agar-ayamsegar/agar-data-collection/hardware/box_v2/airflow-sim.html

Agar · sensor box v2 · airflow study

# Where the fan and sensors should go

Seven ways to build the test box, from the box you have now to a box that holds the smell, mixes it, reads it and flushes itself. Pick a design, switch phases, and watch what the sensor sees. Blue dots are ammonia (lighter than air), orange dots are the heavier spoilage gases.

ammonia, rises amines, H₂S, acids, sink air movement sensor

Drag to rotate · scroll or pinch to zoom

Design

### —

At sensor

0

In box

0

Trapped

0

What the sensor sees, last 40 s of simulated time

Pause Restart this design Labels Air

Simulated time runs about 20× faster than real minutes. Dot counts are relative: compare designs by shape, not by the number.

Before placing the fan

## Ammonia rises. The smell that stays low is the gas under the chicken.

Ammonia weighs 17 g/mol against 29 for air, so in still air it drifts up. Most of the other spoilage gases (amines, hydrogen sulfide, the acids behind “asem”) are heavier and settle slowly. At the tiny amounts a chicken gives off, warm air and the MQ heaters mix things more than weight does, but in a still box it takes minutes.

What really stays at the bottom is the part of the chicken that touches the floor. No air reaches that skin, and the drip that pools there holds a lot of ammonia, because ammonia dissolves easily in water. That gas leaks out slowly and unevenly, so two runs of the same chicken can read differently depending on how it was lying.

The fix is a rack before any fan: a stainless grid 2–3 cm above the floor, with a washable drip tray under it. Then air reaches the underside, and a gentle fan can carry that gas to the sensor.

Gas | g/mol | In still air | Seen by
Air (reference) | 29 | — | —
Ammonia NH₃ · “pesing” | 17 | rises | MQ-137, MQ-135
Hydrogen sulfide H₂S · rotten egg | 34 | sinks a little | MQ-135
CO₂ (bacteria breathing) | 44 | sinks | MQ-135
Ethanol · “glue/solvent” | 46 | sinks | MQ-135
Trimethylamine · fishy, amis | 59 | sinks | MQ-137, MQ-135
Acetic acid · “asem” | 60 | sinks | MQ-135

The seven designs

## Fan, sensor and box, side by side

Whatever you build

## Rules that keep the ratio honest

Same fan state in baseline and sampleMoving air cools the MQ heater and changes the reading by itself. If the fan runs during the sample, it runs the same way, at the same speed, during the baseline.

Never blow straight at the sensorsPut them in the return path of the loop, where mixed air passes at a gentle, steady speed.

In a tube, the fan goes after the sensorsThe air reaches the sensors before it touches the motor, which is warm and can carry its own smell.

Purge through a carbon filterThen every baseline starts from the same clean air, whatever the room smells like. Carbon doesn't remove humidity, so keep logging the DHT11.

New box = new dataset versionTag the JSON with "method": "box_v2_D" (or similar) and run the first few chickens in both boxes, so old and new ratios can be compared.

Chicken in the same spot, every timeCentre of the rack, same side up. Mark the spot on the grid.

Recommended for data collection now

## Design D: hold, mix, flush

It keeps the strong signal of your current closed-box method (the 5-minute hold), adds a short mix so the sensor reads the average air instead of whatever drifted past, and flushes itself with filtered air so you never have to open the lid to purge. Later, the through-flow design (C) is the one that matches the handheld sniffer; run a few chickens in both to learn how the two relate.

Step | Fans | Time
Flush (empty box) | exhaust on, filter inlet open | 2 min
Baseline (empty, closed) | off, then stir 20 s | 5 min
Chicken in on the rack, hold | all off | 5 min
Mix, then read | stir fan on, low speed | 20–30 s
Chicken out, flush | exhaust on | 2 min

Part | Note
Stainless rack + drip tray | 2–3 cm high, washable
Stir fan, 40 mm 5 V | inside, top corner, low speed
Exhaust fan, 40 mm 5 V | on the outlet, top right, outside the box
Inlet with carbon filter | bottom left, opposite the outlet; cap it during the hold
2 × logic MOSFET + diode | so the Arduino switches each fan (IRLZ44N or similar)

This is a qualitative particle simulation to compare layouts: gas dots drift, rise or sink and follow a simple air pattern for each fan setup. It shows where air goes and roughly how fast, not exact concentrations. Check a real build with the breath test and an empty-box flush before collecting data.
