agar-ayamsegar/agar-data-collection/hardware/box_v2/render/part_filter_port.png

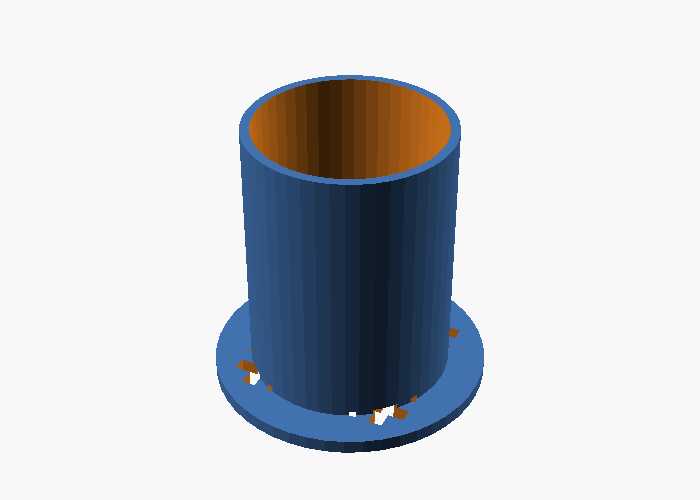
hardware/box_v2/render/part_filter_port.png
