agar-ayamsegar/agar-data-collection/hardware/box_v2/render/part_sensor_wall_mount.png

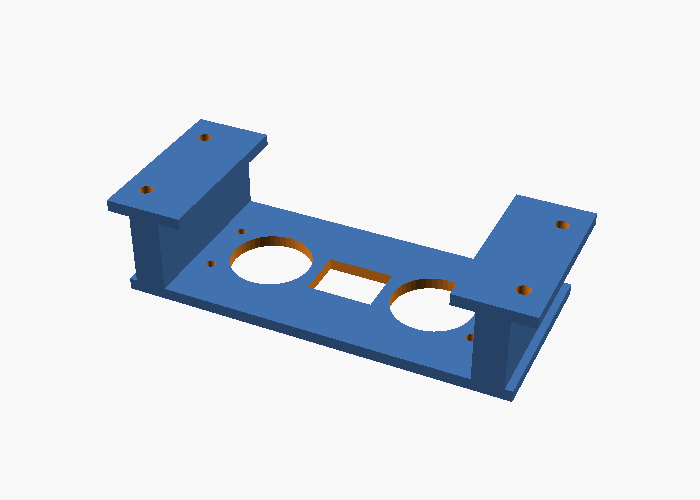
hardware/box_v2/render/part_sensor_wall_mount.png
