agar-ayamsegar/agar-data-collection/hardware/box_v2/render/part_throat_collar.png

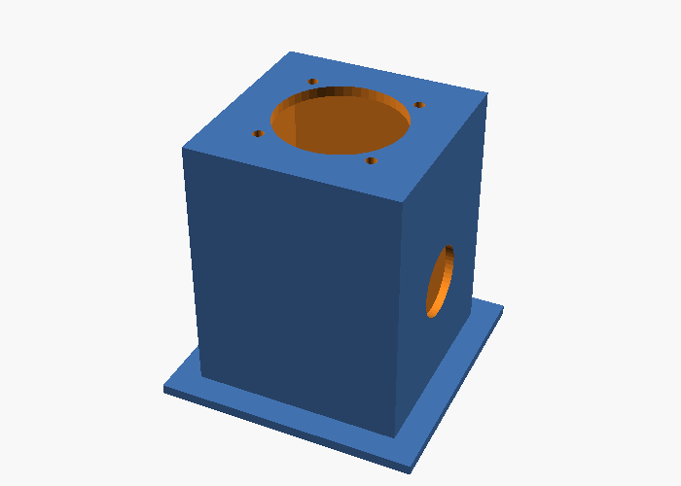
hardware/box_v2/render/part_throat_collar.png
