agar-ayamsegar/agar-data-collection/hardware/box_v2/stl/throat_collar.stl

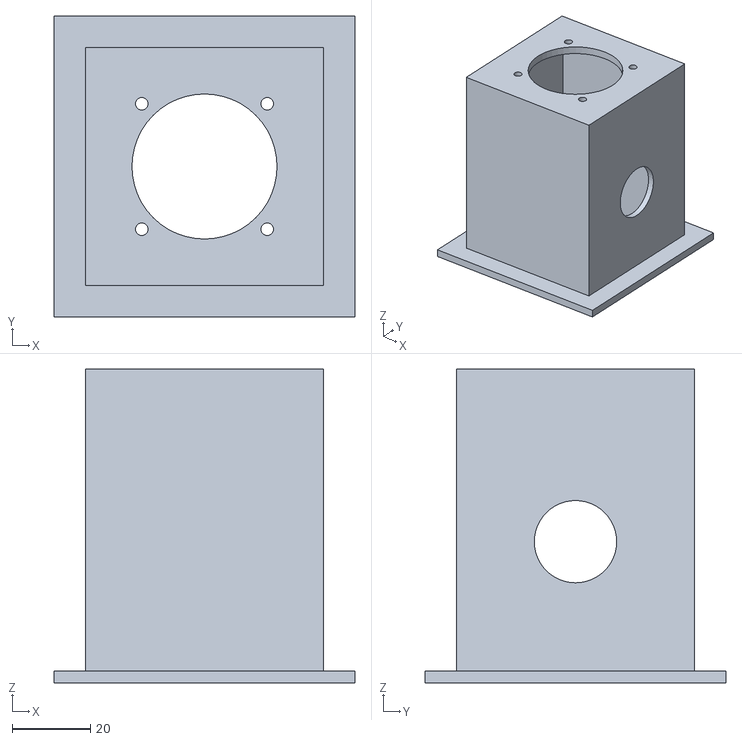
[picture p11: CAD file, 2026-10-28]
hardware/box_v2/stl/throat_collar.stl
76.8 x 76.8 x 80.0
