agar-ayamsegar/agar-data-collection/hardware/box_v2/stl/rack_foot.stl

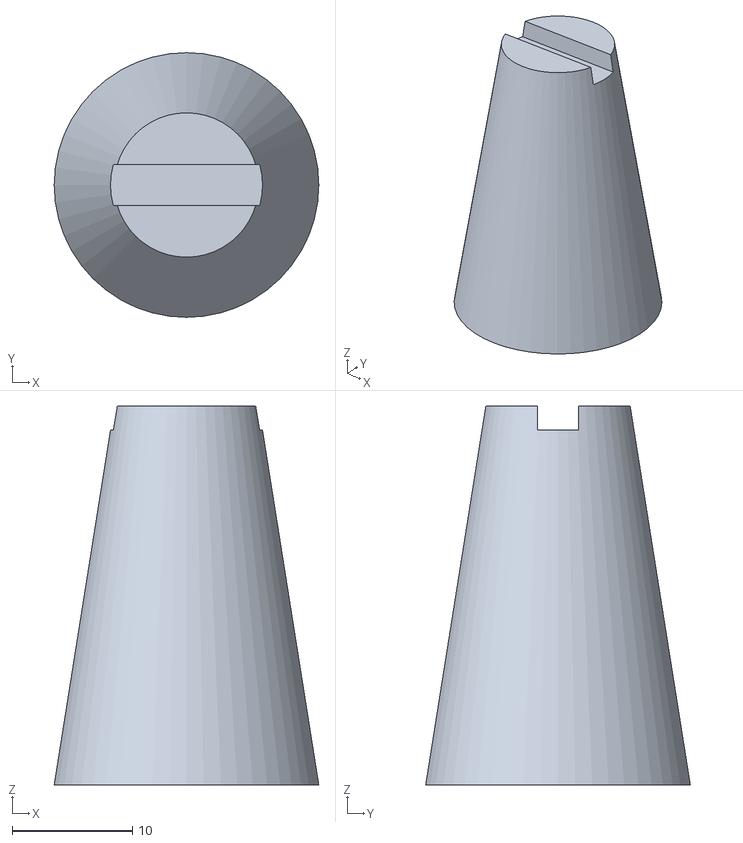
[picture p12: CAD file, 2026-10-28]
hardware/box_v2/stl/rack_foot.stl
22.0 x 22.0 x 31.5
