agar-ayamsegar/agar-data-collection/hardware/box_v2/stl/filter_port.stl

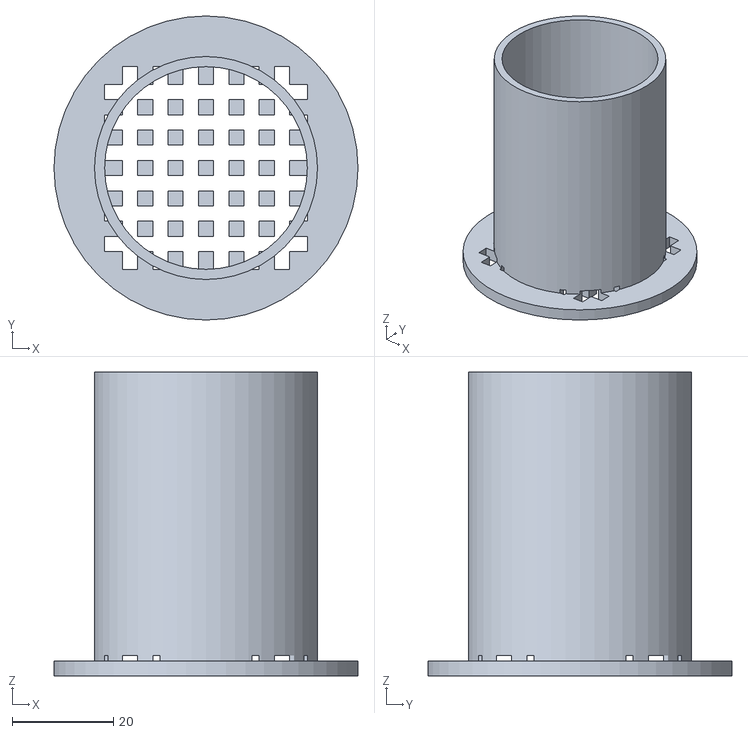
[picture p13: CAD file, 2026-10-28]
hardware/box_v2/stl/filter_port.stl
60.0 x 60.0 x 60.0
