agar-ayamsegar/agar-data-collection/hardware/box_v2/stl/tube_port.stl

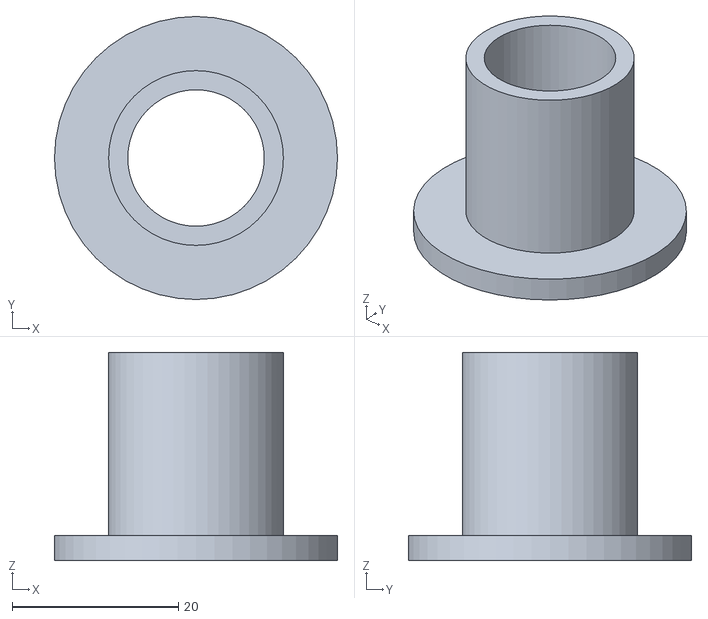
[picture p14: CAD file, 2026-10-28]
hardware/box_v2/stl/tube_port.stl
34.0 x 34.0 x 25.0
