agar-ayamsegar/agar-data-collection/hardware/box_v2/stl/throat_collar_E.stl

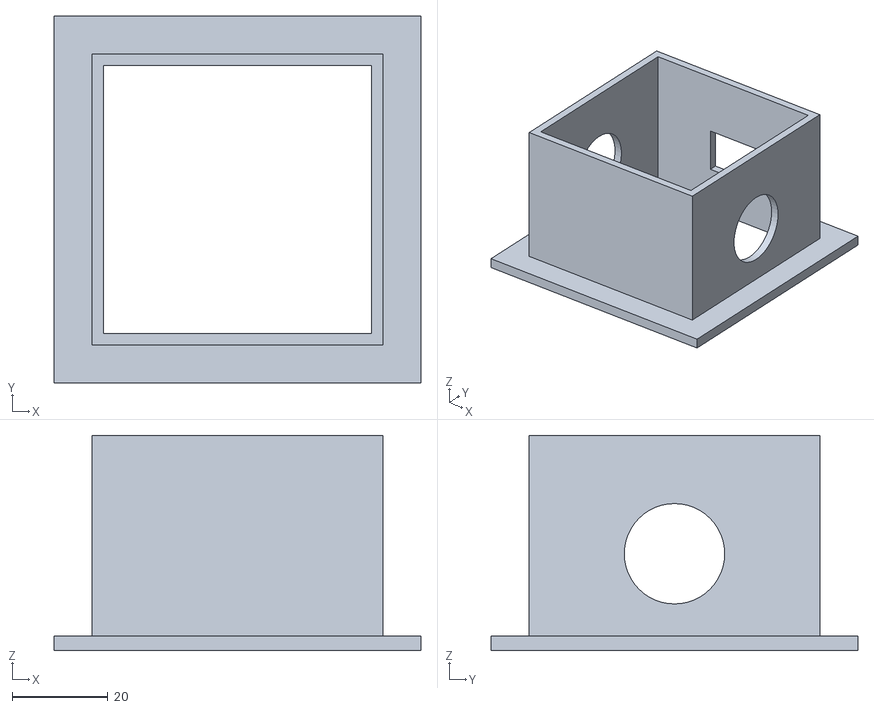
[picture p15: CAD file, 2026-10-28]
hardware/box_v2/stl/throat_collar_E.stl
76.8 x 76.8 x 45.0
