agar-ayamsegar/agar-data-collection/hardware/box_v2/stl/fan_mount_40.stl

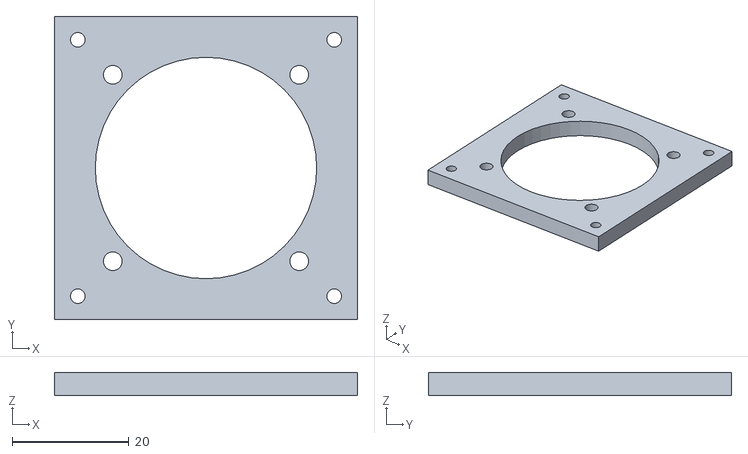
[picture p16: CAD file, 2026-10-28]
hardware/box_v2/stl/fan_mount_40.stl
52.0 x 52.0 x 4.00
