agar-ayamsegar/agar-data-collection/hardware/box_v2/stl/sensor_wall_mount.stl

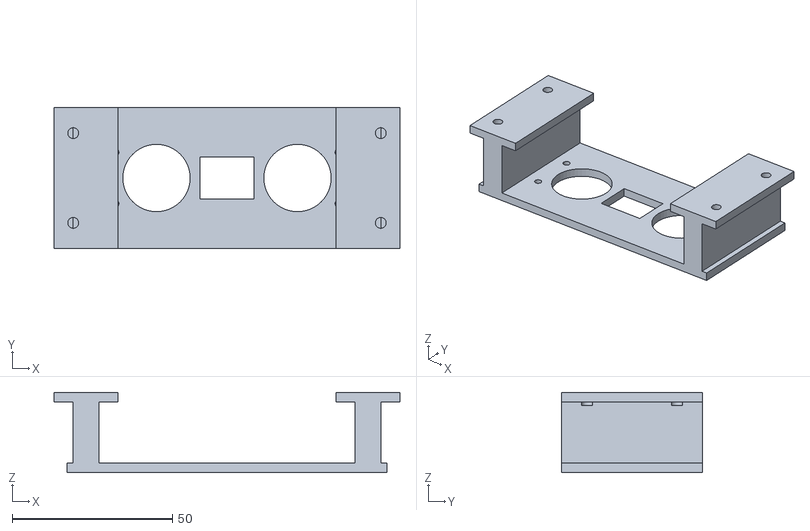
[picture p17: CAD file, 2026-10-28]
hardware/box_v2/stl/sensor_wall_mount.stl
108.0 x 44.0 x 25.0
