agar-ayamsegar/agar-data-collection/(commit log)

2026-10-15 feat: implementing delivery module using rest api and echo
    add sample handler from health/ping, need to do clean-arch for the folder structure and abstraction
2026-10-15 feat: implementing gas logging mechanism
    POST gas single request will insert into mongo and will log bunch of information if failing for easy to trace
2026-10-16 feat: calibration and logger tools for arduino uno
2026-10-18 fix(iot): use 1.1 V internal reference (VREF) for MQ-137/MQ-135
    - The sensor signal is small (~0.15–0.4 V). On the 5 V ruler one step
    is 4.9 mV, so clean air reads raw ~35–55 and small changes are hidden.
    - On the 1.1 V ruler one step is 1.07 mV (4.5x finer). Clean air now
    reads raw ~150–250, so the early freshness drop is visible.
    - VREF must match analogReference, otherwise the voltage is wrong.
    VCC (5 V) is still used for Rs = RL * (VCC - v) / v, because the
    sensors are still powered by 5 V.
    [analyze_run.py, enose_calibration.ino, enose_logger.ino, log_to_json.py, process_run.py, serial_log.py]
2026-10-19 feat(dht11): adding temperature & humidity logging capability
2026-10-28 chore: add context for 3d design
    [box_v2.scad, fan_mount_40.stl, filter_port.stl, rack_foot.stl, sensor_wall_mount.stl, throat_collar.stl, throat_collar_E.stl, tube_port.stl]
